Klink-Solutions/Z-Scale-Decoder/BOM.csv

Item | Qty | Supplier | Cost/item | Total Cost | link
PCB | 1 | JLC PCB | $3.05 | $3.05 | https://jlcpcb.com/
Parts & assembly | 1 | JLCPCB | $82.16 | $82.16 | https://jlcpcb.com/
Estimated total shipping | 1 |  |  | $9.56
