Klink-Solutions/Z-Scale-Decoder/PCB/z_gauge_decoder_v1.0.step

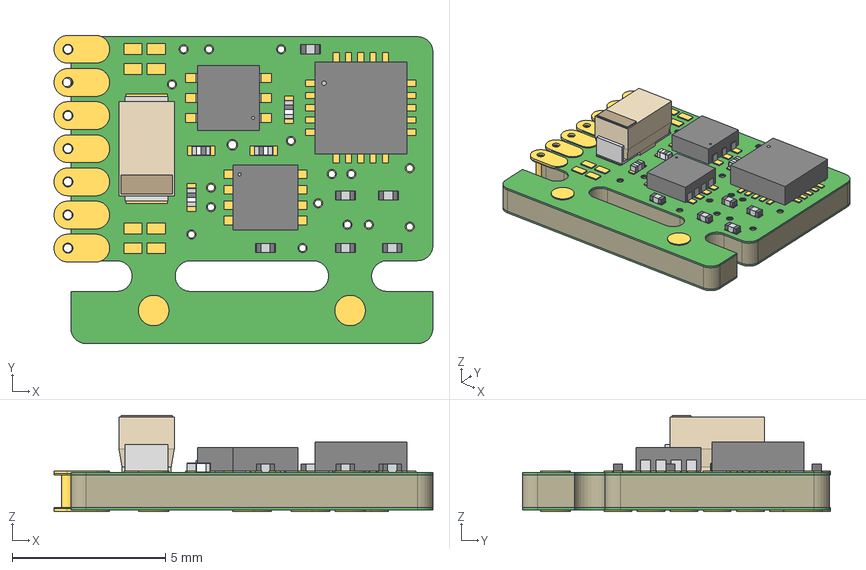
[picture p1: CAD file, 2026-11-08]
PCB/z_gauge_decoder_v1.0.step
12.3 x 10.0 x 3.13 mm
Board
1-copper
64-copper
1-soldermask
64-soldermask
WSON8_DSG_TEX (1)
PMEG3010AESBYL (1) x 4
TAJA_AVX (1)
Ceramic x 4
Marking x 8
Pad_mir x 4
TP127R x 3
Contact_0.3x0.3x0.15 x 12
Body_0.6x0.3x0.3x0.15 x 6
DRV6_1P6X1_TEX (1)
VQFN20_REB_MCH (1)
FID_1MM_P x 2
