Klink-Solutions/Z-Scale-Decoder/PCB/z_gauge_decoder_v1.0.brd

## EAGLE design PCB/z_gauge_decoder_v1.0.brd (2026-11-08)

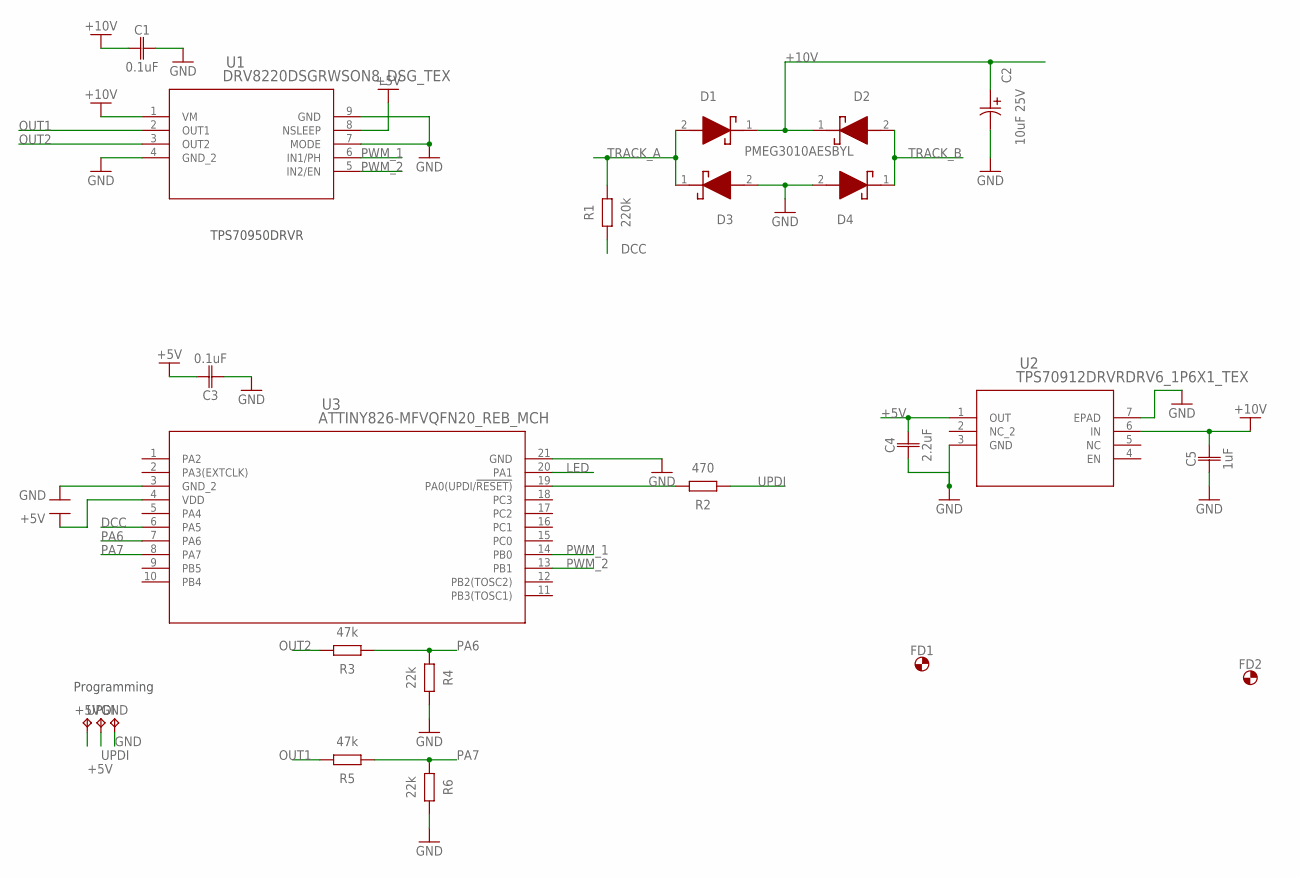
[picture p2: schematic z_gauge_decoder_v1.0.sch, z_gauge_decoder_v1.0]

Parts:
+5V: TPTP127R; TP127R
C1, C3: 0.1uF; WE-MK_0201; MPN GRM033R61E104KE14D
C2: 10uF 25V; TAJA_AVX; MPN TCJA106M025R0150E
C4: 2.2uF; WE-MK_0201
C5: 1uF; WE-MK_0201
D1, D2, D3, D4: PMEG3010AESBYL
FD1, FD2: FID_1MM_P
GND: TPTP127R; TP127R
R1: 220k; WCAP-CSGP_0201_H0.3
R2: 470; WCAP-CSGP_0201_H0.3
R3, R5: 47k; WCAP-CSGP_0201_H0.3
R4, R6: 22k; WCAP-CSGP_0201_H0.3
U1: DRV8220DSGRWSON8_DSG_TEX; WSON8_DSG_TEX
U2: TPS70912DRVRDRV6_1P6X1_TEX; DRV6_1P6X1_TEX
U3: ATTINY826-MFVQFN20_REB_MCH; VQFN20_REB_MCH
UPDI: TPTP127R; TP127R

Connections:
+5V: +5V.TP, C3.2, C4.2, U1.8 (NSLEEP), U2.1 (OUT), U3.4 (VDD)
+10V: C1.1, C2.1, C5.2, D1.1 (K), D2.1 (K), U1.1 (VM), U2.6 (IN)
DCC: R1.1, U3.6 (PA5)
GND: C1.2, C2.2, C3.1, C4.1, C5.1, D3.2 (A), D4.2 (A), GND.TP, R4.2, R6.2, U1.4 (GND_2), U1.7 (MODE), U1.9 (GND), U2.3 (GND), U2.7 (EPAD), U3.3 (GND_2), U3.21 (GND)
LED: U3.20 (PA1)
unnamed: R2.2, U3.19 (PA0(UPDI/!RESET))
OUT1: R5.2, U1.2 (OUT1)
OUT2: R3.2, U1.3 (OUT2)
PA6: R3.1, R4.1, U3.7 (PA6)
PA7: R5.1, R6.1, U3.8 (PA7)
PWM_1: U1.6 (IN1/PH), U3.14 (PB0)
PWM_2: U1.5 (IN2/EN), U3.13 (PB1)
TRACK_A: D1.2 (A), D3.1 (K), R1.2
TRACK_B: D2.2 (A), D4.1 (K)
UPDI: R2.1, UPDI.TP

Notes on the sheet:
TPS70950DRVR
Programming

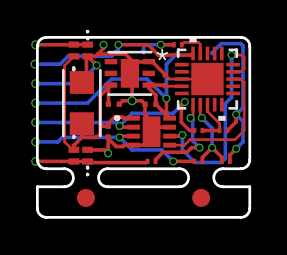
[picture p3: board z_gauge_decoder_v1.0.brd from above]

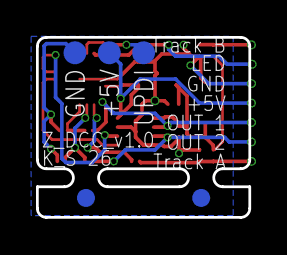
[picture p4: board z_gauge_decoder_v1.0.brd from below]

Board: 2 copper layers, 11.8 x 10.0 mm, 23 parts (3 on the bottom side), 14 nets.
