Klink-Solutions/Z-Scale-Decoder/JOURNAL.md

# Z scale Decoder: devlog

<!-- Generated by Half Life from project y0jpq2nejixcn0cjgwohza48. Edits here are overwritten on the next sync. -->
<!-- Generated: 2026-11-08T21:15:10.489Z -->

> [!NOTE]
> This devlog is mirrored from [Half Life](https://halflife.hackclub.com) ([open the project](https://halflife.hackclub.com/projects/y0jpq2nejixcn0cjgwohza48)). Editing it here will not change the platform's copy, and the next sync overwrites this file.

> Design and manufacture of a custom decoder to work with Z scale model trains. Basic functionality like finer motor control & Led control.

| Week | Tier | Hours logged | Entries |
| --- | --- | --- | --- |
| Week 5 | Tier 1 | 16.73h | 5 |

## Contents

1. [2026-11-08: I had started the week with a quite set idea of what i wanted to achieve - a  decoder for z scale trains and somehow as I was thinking over this project over the past few weeks as it came to me I was](#2026-11-08-i-had-started-the-week-with-a-quite-set-idea-of-w)
2. [2026-11-08: With my new knowledge in hand and seeing I did not need KICad anymore I switched to fusion and went searching for better sized components - it is always quite annoying to upload them but most of this](#2026-11-08-with-my-new-knowledge-in-hand-and-seeing-i-did-no)
3. [2026-11-08: Just a few final tweaks to the schematic and then the challenge of routing everything on the tiny board. At some point space constraints got the better of me and I had to get rid of the TSV diode but](#2026-11-08-just-a-few-final-tweaks-to-the-schematic-and-then)
4. [2026-11-08: The wonders of a good night's sleep can do to your project - in this case it makes you realise it was a bit flawed. A lot of this time was spent fixing the BOM and then realizing that all that work wa](#2026-11-08-the-wonders-of-a-good-nights-sleep-can-do-to-your)
5. [2026-11-08: Genuinely spent far too long trying to get JLC to actually assemble my boards - since I love to take shortcuts and so only made sure to use the same footprint instead of part in Fusion - so when I tri](#2026-11-08-genuinely-spent-far-too-long-trying-to-get-jlc-to)

## Design

### 2026-11-08: I had started the week with a quite set idea of what i wanted to achieve - a  decoder for z scale trains and somehow as I was thinking over this project over the past few weeks as it came to me I was

**2.75h**

I had started the week with a quite set idea of what i wanted to achieve - a  decoder for z scale trains and somehow as I was thinking over this project over the past few weeks as it came to me I was quite certain I knew how to do it - Basically I wanted to add my signal on top of the 10 V DC already on my dreach and then have some basic analog circuitry to decode. It was for this reason I once again started my project in KICad so I could simulate it later.



Being a bit lazy I started with with the easy parts first with some components that I took a while to select but another thing I failed to consider was how big they are since I had not really set my constraints yet.

It was then a good 2 hours into this that as I was doing research I read through how normal decoders work... and well yeah all that work I  just did was down the drain.



The basis of how DCC decoders work led me down a rabbit hole - although this open source version exists it is far to big and over capable for what I need with just motor and led control.

luckily the DCC protocol is largely standardized just that z scale locomotives have a smaller voltage of 10V rather than 12 or higher. the basic principle is that data is sent as rapid square wave over the tack - or as the standardization page puts it

" The DCC signal is a bipolar square waveform, which contains digital information. Long pulses are zero and short pulses are ones. A Command Station sends approximately 8,000 bits per second. The frequency does vary between about 5kHz-9kHz depending on the information sent and the bit duration being near the nominal values and not the max or min values."

Since I also didn't  know what all this meant at first  I found a helpful page that better explained what this signal than actually looks like if you were to analyse it.



### 2026-11-08: With my new knowledge in hand and seeing I did not need KICad anymore I switched to fusion and went searching for better sized components - it is always quite annoying to upload them but most of this

**3.08h**

With my new knowledge in hand and seeing I did not need KICad anymore I switched to fusion and went searching for better sized components - it is always quite annoying to upload them but most of this time was just looking for a component then getting it into fusion and understanding from the data sheets how to hook it up

I also had to take the time to find new packages for everything since in my further research I decided i want this board to be small enough to fit on some standard train carriages so that limited me to about  12x7.5mm

[Timelapse](https://lookout.hackclub.com/api/media/8c427022-5c45-42d4-946a-a716ea26d2e9/video.mp4)

### 2026-11-08: Just a few final tweaks to the schematic and then the challenge of routing everything on the tiny board. At some point space constraints got the better of me and I had to get rid of the TSV diode but

**4.23h**

Just a few final tweaks to the schematic and then the challenge of routing everything on the tiny board. At some point space constraints got the better of me and I had to get rid of the TSV diode but I think that will be ok. For now I think it's almost done but I would not be surprised if I need to re-do a majority of this.

[Timelapse](https://lookout.hackclub.com/api/media/5dee0d47-6523-42bd-bc48-9623be8d981e/video.mp4)

### 2026-11-08: The wonders of a good night's sleep can do to your project - in this case it makes you realise it was a bit flawed. A lot of this time was spent fixing the BOM and then realizing that all that work wa

**3.92h**

The wonders of a good night's sleep can do to your project - in this case it makes you realise it was a bit flawed. A lot of this time was spent fixing the BOM and then realizing that all that work was basically for not since JLC can't assemble boards so small  so in an act of desperation I have added sort of break off tabs  to stretch to board to the minimum size - also went down a small rabbit home of what the heck a fiducial mark is and how technically I need them for each IC but no way I can fit this so I let JLC take care of that for me I hope

[Timelapse](https://lookout.hackclub.com/api/media/7d34e732-7627-4dbb-83a7-e56e3d51c12c/video.mp4)

### 2026-11-08: Genuinely spent far too long trying to get JLC to actually assemble my boards - since I love to take shortcuts and so only made sure to use the same footprint instead of part in Fusion - so when I tri

**2.75h**

Genuinely spent far too long trying to get JLC to actually assemble my boards - since I love to take shortcuts and so only made sure to use the same footprint instead of part in Fusion - so when I tried to then export the mechanical files I went insane trying to upload them again and again after it saying no can do. What did  it in the end was thing the sample files and manually putting in each component name, part number , location , rotation by hand which took me far too long. Also I dislike Microsoft excel with a passion so it was extra bad.
