Klink-Solutions/Z-Scale-Decoder/(commit log)

2026-11-08 Sync Z scale Decoder from Half Life
    [BOM.csv]
2026-11-08 Add BOM section to README
    Added a Bill of Materials (BOM) section with component details.
