Klink-Solutions/Z-Scale-Decoder/(notices)

Notices in the files:
parts and their libraries:
2026-11-06_20-55-51_Library: COPYRIGHT: Copyright (C) 2026 Ultra Librarian. All rights reserved.
